yuyoi/M-one-rack-screen-and-os-mod-/(commit log)

2026-10-16 First public release: OS boots with sound, full front panel UI
    - Analog outputs work without the front panel: dsp/codec_on.py writes the
    AK4524 run values and drives MUTE* (PB12) LOW. On this board that pin
    mutes when high or open, despite its name. TC itself runs with it low.
    - tools/mone.py boot loads autotune + os + codec_on and starts codec_on,
    which un-mutes and then starts the kernel at $0A00.
    - ESP32-S3 front panel: FX / TUNE / SYSTEM pages, BUTTON TEST page,
    idle face, 14 buttons learned by position, 3 pots, encoder, WiFi serial
    + OTA, WiFi signal (dBm) on the SYSTEM page.
    - Backlight auto-off with the DSP off: 5 minutes.
    - Test tone (dsp/tone.py) and input probe (dsp/inpro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
2026-10-16 Keep the DSP in sync with the panel after every boot
    A freshly booted kernel starts on its own defaults (SINGLE / HEAVY /
    REVERSE), so the screen and the sound could disagree, and a bypass set on
    the panel was lost on the DSP side.
    - ESP: uiPushAll() sends mode, FX1/FX2 (bypassed = CLEAN) and the 13 tune
    values in one halt; serial 'U' runs it and prints what it sent.
    - mone.py boot sends 'U' right after starting the OS.
    Verified on hardware: boot -> "PUSHED mode=0 fx1=1 fx2=2", DSP readback
    matches, kernel running at $0A34.
    [menu.h, mone.py, mone_dev.ino]
2026-10-16 Pots: volume, mix and tone on every effect; CLEAN at boot; JTAG fixes
    - Kernel output stage after every mode (dsp/os.py): dry/wet crossfade,
    one-pole tone low-pass, volume. Params at X:$2F, $3D, $3E, $3C.
    - ESP: POT1 volume (40 dB taper), POT2 mix (linear), POT3 tone
    (400 Hz..20 kHz, far right = off). Sent when moved, at most every
    100 ms; included in the after-boot push.
    - FX1 boots as CLEAN on both sides (HEAVY is +60 dB: noise on a mic).
    - No OnCE writes while the power switch is off. A failed halt reloads
    IDCODE so a DSP held in reset doesn't come up halted.
    - Simulator: MPYR / MACR. The whole-OS tune test still gives A3 -3.5 c,
    1248 instr/frame.
    Verified on hardware: pushed v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
    [controls.h, menu.h, mone_dev.ino, os.py, sim56.py]
2026-10-16 Singing face: the idle face follows the audio level
    - Kernel: peak envelope of the output (~150 ms release, X:$19) written to
    OGDB (X:$FFFFFC) every frame, 8 instructions.
    - ESP: dspLevel() reads OGDB over JTAG while the core runs (OnCE is
    accessible in Normal mode, DSP56300FM ch. 7), so no halt and no audio
    blip. Serial 'A' prints it.
    - Face: the mouth opens with the level (-48..-6 dBFS), loud parts close
    the eyes to ^ ^, the head lifts, eighth notes float up. Sound keeps it
    from dozing but doesn't bring the menu back.
    - Simulator: OGDB writes. Whole-OS tune test unchanged (A3 -3.5 c),
    1256 instr/frame.
    Verified on hardware: 12 reads with the kernel running, -38 dBFS after
    boot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
    [face.h, mone_dev.ino, os.py, sim56.py]
2026-10-16 ESP adopts the DSP's mode/FX at startup
    After an ESP reboot (OTA) the DSP keeps playing, but the panel came back
    on its defaults, so the screen showed CLEAN while COMP was playing.
    setup() now reads the power switch first, then X:$20-$22 from the DSP in
    one halt (new onceReadXMany) and takes them over if they are in range.
    'V' also prints the panel's menu state.
    Verified on hardware: after an OTA reboot the panel shows mode=0 fx1=3
    fx2=2, the same as the DSP readback.
    [menu.h, mone_dev.ino]
2026-10-16 Amp-sim research models: modeled chain and LSTM capture
    - dsp/model/amp_model.py: float reference of a modeled amp (4x oversampled
    asymmetric triode stages, Yeh & Smith TMB stack, power amp with sag,
    512-tap cab IR) with a DSP56362 cycle tally (916 cycles/frame = 43% of
    2112), aliasing test (4x: -30..-39 dB vs -13..-16 dB at 1x) and demo
    renders from a synthetic DI.
    - dsp/model/lstm_model.py: LSTM capture cost per hidden size (fits up to
    H=12 at 57%) and a 24-bit fixed-point check with table activations
    (78-105 dB vs a saturating float reference).
    Research only: nothing here runs on the DSP yet.
2026-10-16 DSP cycle ceiling measured; kernel meter build; memory-switch probe
    - dsp/cycprobe.py: silent REP-N-NOP sweep. 93.1 MHz core = 2112 cycles/frame,
    ~2070 free in a bare loop, external SRAM read ~2.1 cycles.
    - py os.py meter: os_meter.hex keeps a histogram of idle spins per frame at
    X:$1100. Per frame: kernel+CLEAN ~85 cycles, HEAVY +55, REVERSE +80,
    COMP +45, TUNE +180 typical / +1325 worst. The normal os.hex is unchanged.
    - dsp/ms_on.py: TC's boot already sets OMR MS (OMR $000B81), so P RAM is
    $0000-$13FF; P:$1200 loaded and ran on hardware. Fallback switch program.
    - sim56: REP reg.
    All run on hardware 2026-10-16 with the outputs muted or silent.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
    [cycprobe.py, ms_on.py, os.py, sim56.py]
2026-10-16 VOX: vocal chain for a crystal ham mic (effect 5)
    dsp/vocal.py at P:$0700 (loaded by `boot` as vocal.hex): HPF 80 Hz,
    +5 dB body at 180 Hz, -4 dB at 1 kHz and 3.5 kHz, leveling compressor,
    light tube (2nd + 3rd harmonic, DC block), exciter (above 3 kHz,
    soft-clipped, mixed in) and a 110 ms slap with low-passed repeats.
    ~160 instructions per sample.
    - dsp/model/vox_model.py: reference model (exact mode truncates like the
    DSP); sim_vox.py runs the whole OS and matches it to 2.4e-7.
    - menu.h: FX name VOX, N_FX = 6. mone.py boot loads vocal.hex.
    Hardware 2026-10-16: boot OK, coefficients + state read back, VOX picked
    from the ESP menu (outputs muted), X:$21 = 5 and the slap index running.
    No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
2026-10-16 Wiring diagram on the README: J8, J5 + power switch, ESP pins
    docs/wiring.png, drawn by tools/draw_wiring.py in the OS's heavy-metal
    theme: J8 JTAG/OnCE to GPIO 12/11/13/10/4 + GND, J5-4 5V into the ESP's
    5V pin, the DPDT power switch (pole A: J5-16 DSP reset <-> J5-17 3V3,
    pole B: GND <-> GPIO 3 sense), and every used ESP32-S3-DevKitC-1 pin
    colour-coded (screen, pots, ladders, encoder, buttons). J5-10/13 (+/-15 V)
    are flagged.
    [draw_wiring.py]
2026-10-16 PS1 heavy-metal theme: canvas UI, boot splash, mock pedals, encoder IRQ
    - theme.h: black + molten orange/yellow, 15-bit colour, Bayer-dithered
    gradients, 5x7 pixel font, chunky metal titles; pages draw into a 120x120
    canvas pushed at 2x (48 ms per frame on the hardware).
    - Animated: header lava wave + flickering flames, rows fly in on page
    open, shimmering selection bar with a pulsing cursor (~9 fps).
    - Boot splash: spinning flat-shaded low-poly diamond + flame progress bar.
    - FX / TUNE / SYSTEM / BUTTON TEST / LEARN pages ported; SYSTEM shows pot
    bars, ladders, encoder, DSP state, WiFi dBm + IP.
    - Idle screen: VOCAL effects get the singing face (ember glow pulses with
    the level);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
2026-10-16 EDIT page (T5) + RADIO / FORMANT / OCTAVE settings over long X writes
    - FX list grows to 10: AMP (pedal), RADIO, FORMANT, OCTAVE (vocal).
    - onceWriteXLong: move #v,x0 ; move x0,x:$aaaa, all values in one halt.
    - EDIT page on T5, for FX1 (or FX2 when FX1 has no settings):
    RADIO: mode (telephone/megaphone/AM/walkie/cassette/vinyl), wet,
    drive, noise. FORMANT: voice preset (giant, monster, chipmunk, elf,
    M>F, F>M, custom), throat, pitch in semitones, wet, gain.
    OCTAVE: pitch, throat, wet, gain. Encodings per VOCAL_ARCH.md.
    - The after-boot push also writes all 12 setting words.
    Verified on hardware: 'U' push, then X:$0210-$0233 read back, all 12
    words as expected.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
    [menu.h, mone_dev.ino]
2026-10-16 RADIO (6 modes), FORMANT + OCTAVE (PSOLA), TUNE detector spread over 4 frames
    - RADIO (id 7, vocal.py, now at P:$0100): TELEPHONE, MEGAPHONE, AM RADIO,
    WALKIE (squelch burst), CASSETTE (wow + flutter), VINYL 78 (crackle).
    Band, AGC, drive, sample-and-hold + bit mask, hiss, wobble delay / horn
    comb, crackle, gate. Mode tables live in external SRAM (vocal_tab.hex at
    $03C000; P, X and Y alias there). Params X:$0210.
    - FORMANT (id 8) and OCTAVE (id 9), vocal2.py at P:$0700: one PSOLA engine,
    two instances (pitch marks, 4 grain slots, 48-bit timers and positions).
    Params X:$0220 / X:$0230. Period from TUNE's detector.
    - autotune: tune_detect is its own routine, run at most once a fram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
    [asm56.py, asmh.py, autotune.py, dis56k.py, fxmeter.py, mone.py, os.py]
2026-10-16 AMP (effect 6): modeled tube amp on the DSP, bit-exact with its reference in the sim
    DC blocker, 4x polyphase oversampling, three triode stages (coupling HPF, gain, dynamic bias,
    cubic clip, Miller LPF), 48-tap decimator, TMB tone stack, power amp (resonance, presence, sag,
    drive, soft clip) and a 512-tap cab IR. Code P:$0C00-$0DEF; tables in SRAM at $031C00, copied
    to internal RAM on the first call; params X:$12C0-$12EF.
    model/sim_amp.py: 5292 of 5292 samples bit-exact against model/amp_ref.py, 1299 instr/frame.
    Not on hardware yet: needs the kernel table entry and the boot-list hook-up.
    [amp.py]
2026-10-16 CHAIN mode, REVERB + DELAY, AMP hooked in as effect 6, DSP load cut
    - Kernel: CHAIN mode (X:$20 = 3): X:$0200 = n, X:$0201-$0206 = effect ids
    in series (unknown ids skipped). The tone filter is now k*x + (1-k)*lp
    (no saturating difference on full-scale jumps). Table: 6 AMP (amp.py,
    P:$0C00), 10/11 CLEAN placeholders, 12 REVERB, 13 DELAY.
    - vocal3.py (P:$1000): REVERB = Dattorro plate at 22 kHz, one tick over
    two frames, ROOM/PLATE/HALL via size/decay/damping, FREEZE, read indexes
    cached on SIZE change. DELAY = half-rate line (up to ~740 ms), tone,
    tape wow + saturation, 4-tap mode, ducking. Tables in vocal3_tab.hex.
    - PSOLA: 1/P from an SRAM table (vocal2_tab.hex), setup cached o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
    [asm56.py, asmh.py, autotune.py, fxmeter.py, mone.py, os.py]
2026-10-16 HARMONY, DOUBLER, SHIMMER, SWELL and the STRIP input stage
    - vocal4.py (P:$1220): two-head shifter shared by HARMONY (id 10: 2 voices
    from TUNE's note through 12-entry maps, diatonic or fixed) and SHIMMER
    (id 14: shifted reverb output fed back into the reverb input); DOUBLER
    (id 11: 2 wobbling delays). Tables in vocal4_tab.hex.
    - vocal5.py (P:$0310): STRIP (X:$0207 on: low cut, gate, de-esser,
    leveler, EQ biquad, drive) runs on the input before the routing; SWELL
    (id 15: fade-in after silence).
    - Models harmony_model / strip_model; sims match the DSP to 1-3 LSB
    (the kernel output stage). fxmeter can switch STRIP on in a chain.
    Hardware 2026-10-16, outputs muted: all boot and run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
    [fxmeter.py, mone.py, os.py]
2026-10-16 GRAIN (effect 16): granular cloud in the free vector area
    - vocal6.py at P:$0060-$00FF (unused interrupt vectors; interrupts are
    masked, $0000-$005F left alone): 2 grain voices from the last ~1.5 s
    (REVERSE's buffer, never chained together), random starts, triangle
    windows, optional +12 sparkle. Params X:$02C0.
    - grain_model.py; sim matches to 1 LSB. Kernel limit back to P:$0BFF
    (the meter build needs the room).
    Hardware 2026-10-16, outputs muted: GRAIN 302 cycles/frame worst,
    GRAIN->REVERB ~870. Normal OS rebooted with sound afterwards.
    [fxmeter.py, mone.py, os.py, vocal6.py]
2026-10-16 presets.py: the 56 vocal presets as data, all run on hardware
    dsp/presets.py builds every preset of VOCAL_PRESETS.md from the model
    param helpers: chain (CHAIN mode), STRIP on/off + params, each effect's
    param block, TUNE/HARMONY key specs. `presets.py json` is the input for
    the ESP's presets.h generator.
    fxmeter.py `presets` (or preset:N) loads a preset's writes through a
    small SRAM table + poke loop and measures it, outputs muted.
    Hardware sweep 2026-10-16: all 56 run; worst cycles/frame of 2112 range
    from ~390 (PODCAST VOICE) to ~1780 (DEMON CHOIR, ANGEL CHOIR). One run
    of INFINITE HALL read a stale histogram (GO not taken); rerun: ~610.
    fxmeter now flags stale histograms.
    Co-Authored-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
2026-10-16 Panel: PRESET page (56 presets), STRIP row, EDIT pages for every vocal effect
    - PRESET page (T4): the knob loads the previous / next preset once it rests, enter = list by type, R2 = back.
    A preset is CHAIN mode + STRIP + every setting in one halt; TUNE's snap map and HARMONY's maps are
    recomputed for the TUNE page's key. The EDIT pages show the preset's values; the last preset is kept in
    NVS and taken back after an ESP reboot when the DSP still plays its chain. B1 bypasses a preset's chain.
    - tools/gen_presets.py: dsp/presets.py -> firmware/mone_dev/presets.h.
    - FX page: 17 effects, STRIP row (X:$0207, T5 on it = STRIP settings), CHAIN routing line.
    - EDIT pages: REVERB, DELAY (TYPE pr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
    [gen_presets.py, menu.h, mone_dev.ino]
2026-10-16 Panel: AMP EDIT page + pedal mode
    - AMP rows: TYPE (CLEAN / CRUNCH / LEAD), GAIN, BASS, MID, TREBLE, PRESENCE,
    RESONANCE, DRIVE, SAG, MASTER. The ESP computes the tone stack itself.
    - Tone stack factoring (amp_ref.tmb_sos, menu.h ampTmb):
    - Yeh's cubic, bilinear; the real pole by Newton from z = 1.
    - First order (h, -h, p) carries the DC zero.
    - MID is held <= 0.99 (at MID 1 / BASS 0 a pole sits on z = -1).
    - PRESENCE is now a wide 3 kHz peak: a shelf overflows the /2 format above +3 dB.
    - amp_ref.ui_words is the reference for the panel's 24 words.
    The ESP matches it to 0 LSB over 127 settings (serial 'a').
    - Only the changed group is written, so pot sweeps stay short halts.
    - ampF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
    [face.h, menu.h, mone_dev.ino]
2026-10-17 Panel: 3D MODE ring, back-step EXIT, PEDAL board, encoder noise fix
    - The boot screen is a MODE ring (ring3d.h): low-poly 3D icons, flat shaded
    with specular highlights, turning over a Castlevania night.
    - tuxedo cat = VOCAL FX, vinyl = PRESETS, '69 stompbox = PEDAL,
    chrome cog = SETTINGS, bible = SYSTEM
    - a crown marks the mode that is playing
    - mounted parts hide with their face, so nothing pops through a spin
    - EXIT steps back along the path you took (nav stack), down to the ring.
    Each page keeps its cursor.
    - PRESETS always opens on a playing preset (the last one, else 01).
    - PEDAL board: each pedal is drawn with its own knobs (1-6). The knob slides
    to the next pedal and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
    [controls.h, face.h, gen_sprites.py, menu.h, mone_dev.ino, ring3d.h, theme.h]
2026-10-17 Panel: 14 swappable MODE-ring backgrounds (SETTINGS > SCENE)
    Night, two dungeons, throne hall, crystals, two castles, and seven 80s
    scenes (outrun, vaporwave, cyber city, matrix, tron, neon pink, inferno).
    Each is drawn once into the cached sky sprite and saved in NVS; the floor
    ring takes the scene's colours, and stars twinkle on the night scenes only.
    [bg.h, menu.h, ring3d.h]
2026-10-17 Panel: 14 menu colour themes (SETTINGS > THEME)
    The menu colours are now a palette swapped at run time: FORGE (the original
    orange), INFERNO, AMETHYST, ROYAL, FROST, CRYSTAL, ROSE, OUTRUN, VAPOR, CYBER,
    MATRIX, TRON, NEON and BLACK WHITE. MATCH SCENE (the default) gives each
    scene its own; the choice is saved in NVS and applied before the boot splash.
    SETTINGS rows close up to fit five. Checked on the unit.
    [bg.h, menu.h, mone_dev.ino, theme.h]
2026-10-17 Panel: pot order matches the front (POT 1 = left knob)
    GPIO 7 is the front's left knob and GPIO 5 its right, so PIN_POT is now
    {7, 6, 5}: LEVEL / volume on the left and TONE on the right, as the PEDAL
    board draws them. Checked on the unit.
